vintagefilmography/homemade-telecine/README.md

# homemade-telecine
Homemade telecine unit to work with your existing DSLR.

This repo contains the instructions and parts list for the homemade telecine. The unit can be used with your existing camera 
with a macro lens.  
Read the enclosed manual for details.
