vintagefilmography/homemade-telecine/gate_design/film_gate1.jpg

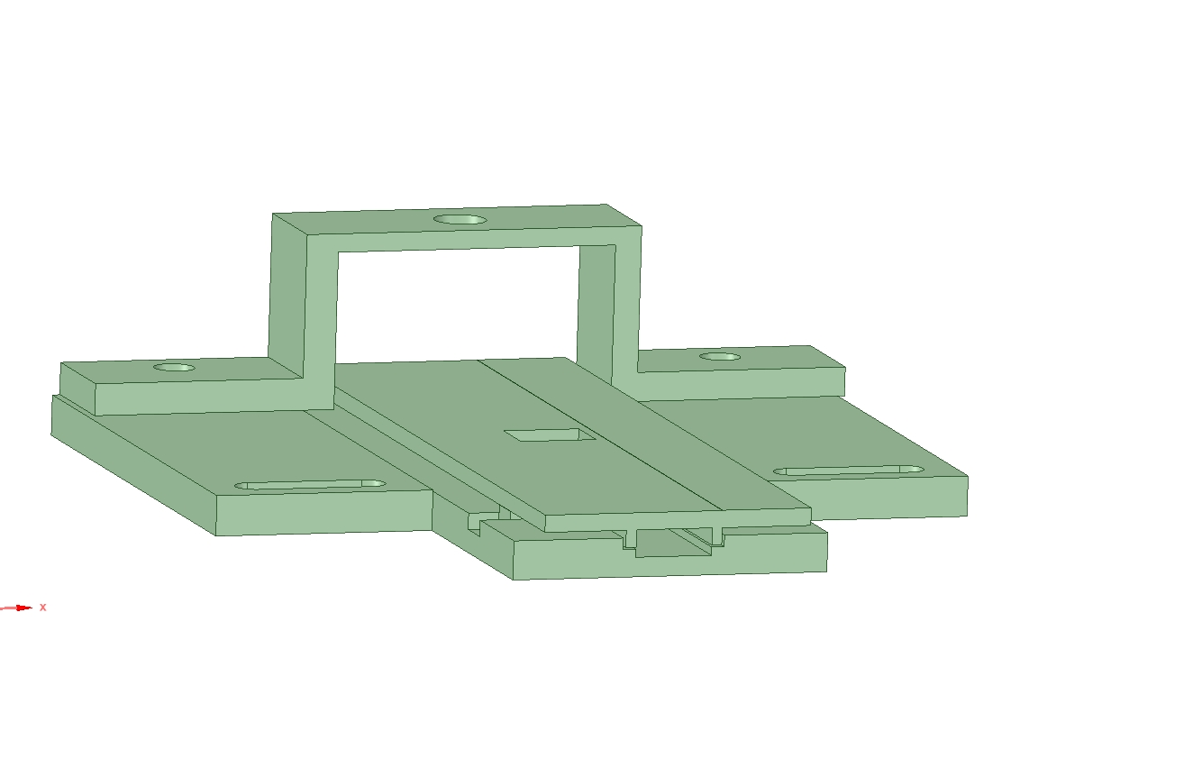
gate_design/film_gate1.jpg
