vintagefilmography/homemade-telecine/gate_design/film_gate2.jpg

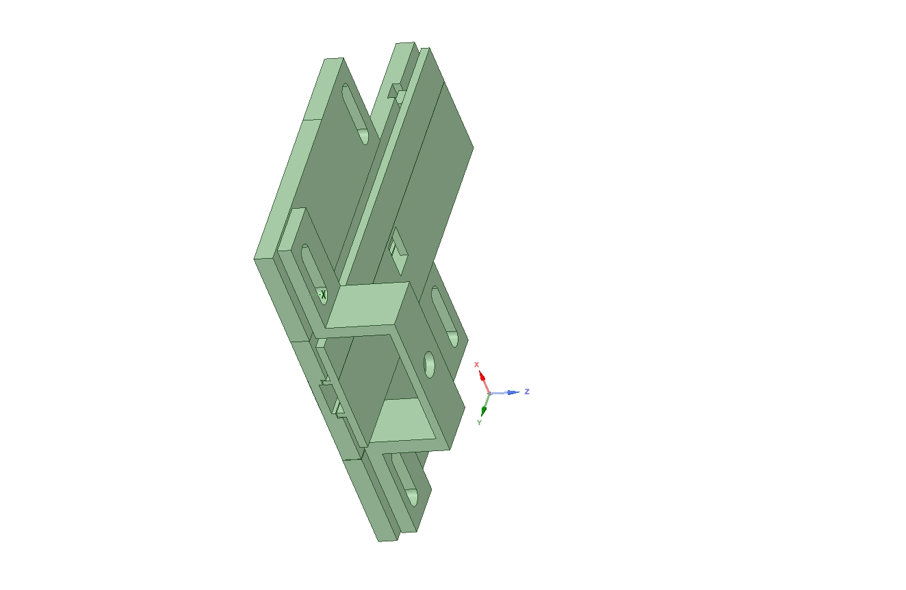
gate_design/film_gate2.jpg
