vintagefilmography/homemade-telecine/gate_design/film_gate.jpg

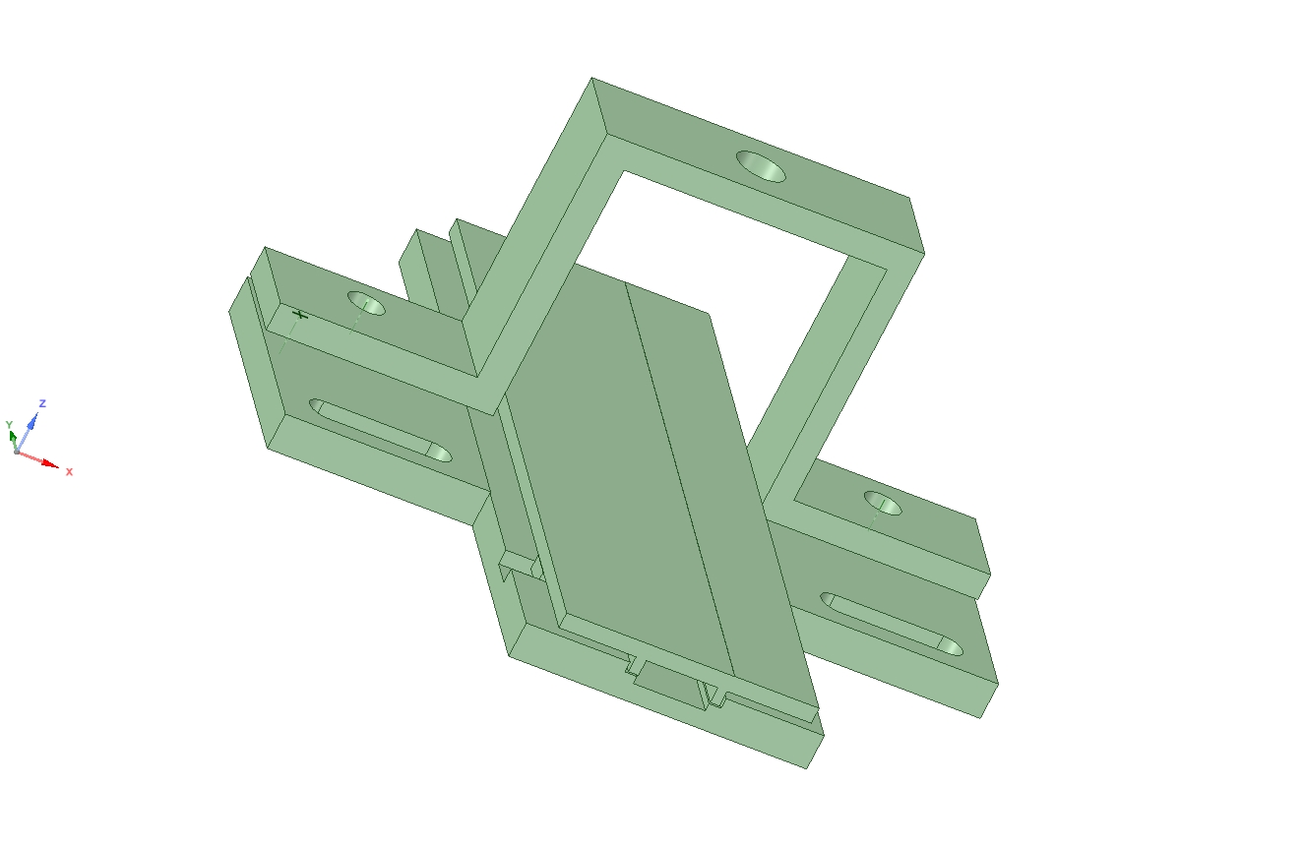
gate_design/film_gate.jpg
