vintagefilmography/homemade-telecine/gate_design/film_gate_concept3.jpg

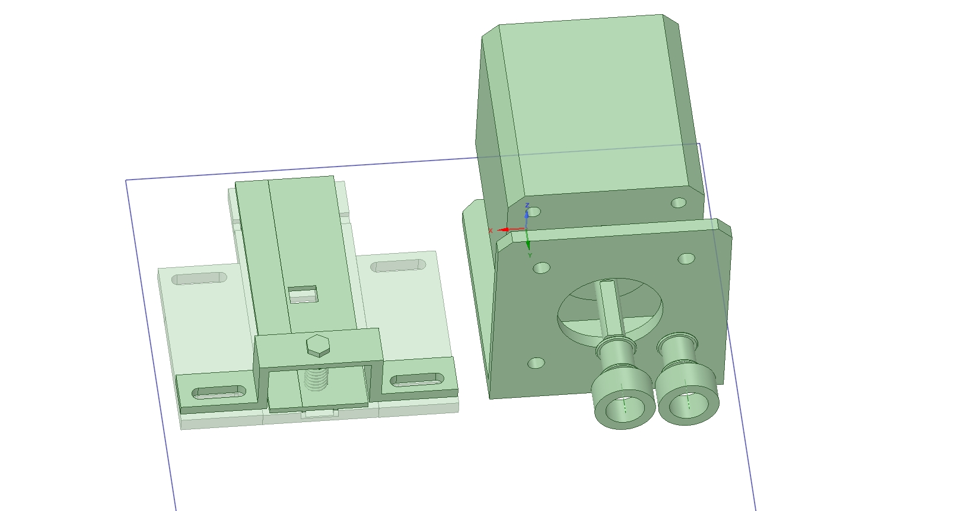
gate_design/film_gate_concept3.jpg
