vintagefilmography/homemade-telecine/gate_design/film_gate_concept.jpg

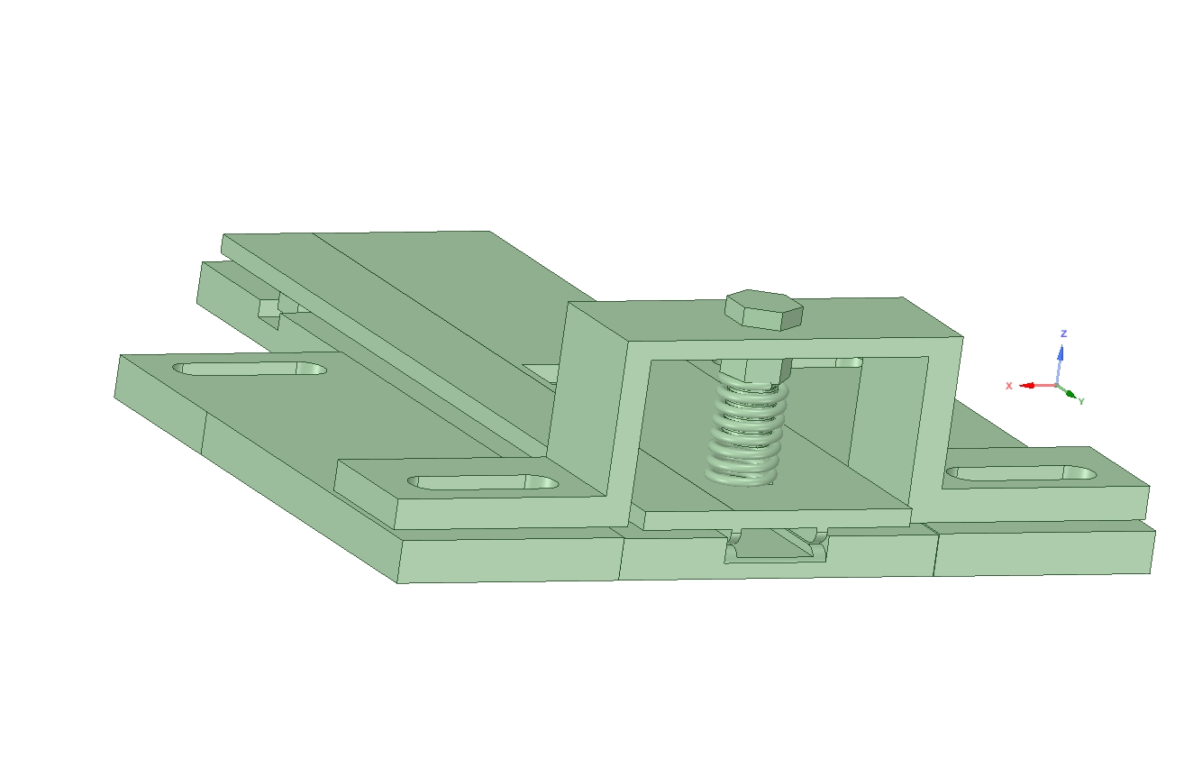
gate_design/film_gate_concept.jpg
