vintagefilmography/homemade-telecine/BOM-hawkeye2-V1.xlsx

Sheet: Sheet2
Ref | Qty | Part Num | Description | Value | Supplier | Cost | Ext Cost | Notes
C1 - not needed | 0 | 647-UMA1H010MDD1TP | Cap | 1uF | Mouser | 1.7 | 0
C2 - not needed | 0 | C322C104K5R5TA7303 | Cap | 0.1uF | Muser | 1.35 | 0
D1,D2,D3 | 1 |  | Diode |  | Amazon | 0.1 | 0.1 | https://www.amazon.com/gp/product/B01M9GOEFT/ref=ppx_od_dt_b_asin_title_s00?ie=UTF8&psc=1
IC1 | 1 | MSP430G2231IN14 | Controller |  | Mouser | 1.54 | 1.54 | 9
IC2 | 1 | NCP1117ST33T3G | Regulator |  | Digikey | 1.3 | 1.3
J3,J5,J8,J11 J1,J15 opt | 4 | WM1731-ND | Conn 2 pin |  | Digikey | 1.19 | 4.76
J4,J6,J26 | 3 | WM1733-ND | Conn 4 pin |  | Digikey | 0.28 | 0.84 | 5
 | 1 |  | Socket | DIP-14 for IC1 | Amazon | 1.2 | 1.2 | https://www.amazon.com/gp/product/B013SYPY9G/ref=ppx_od_dt_b_asin_title_s00?ie=UTF8&psc=1
Q1 - for capstan | 1 | IRF540NPBF | Mosfet |  | Amazon | 0.9 | 0.9 | https://www.amazon.com/gp/product/B07PH6FPZR/ref=ppx_od_dt_b_asin_title_s00?ie=UTF8&psc=1
R1,R4,R5,R6,R7 | 5 |  | Res | 10K | Amazon | 0.1 | 0.5 | https://www.amazon.com/gp/product/B07HDGX5LM/ref=ppx_yo_dt_b_asin_title_o06_s00?ie=UTF8&psc=1
R2 | 1 |  | Res | 3K | Amazon | 1.3 | 1.3 | https://www.amazon.com/gp/product/B07QG1VKCC/ref=ppx_yo_dt_b_asin_title_o00_s00?ie=UTF8&psc=1
R3 | 1 |  | Res | 100 | Amazon | 0.1 | 0.1 | https://www.amazon.com/gp/product/B0185FIDDW/ref=ppx_yo_dt_b_asin_title_o00_s00?ie=UTF8&psc=1
R5 | 1 |  | Res | 2.2K | Amazon | 0.1 | 0.1 | https://www.amazon.com/gp/product/B0185FIDDW/ref=ppx_yo_dt_b_asin_title_o00_s00?ie=UTF8&psc=1
R8 | 1 |  | Res | 1.7K | Amazon | 0.1 | 0.1 | https://www.amazon.com/gp/product/B07QG1V4YL/ref=ppx_yo_dt_b_asin_title_o06_s00?ie=UTF8&psc=1
R9 | 1 |  | Res | 1K | Amazon | 0.1 | 0.1 | https://www.amazon.com/gp/product/B07QG1V4YL/ref=ppx_yo_dt_b_asin_title_o06_s00?ie=UTF8&psc=1
 | 5 | WM15251-ND | Cable 2 pin |  | Digikey | 2.46 | 12.3
 | 2 | WM15259-ND | Cable 4 pin |  | Digikey | 3.54 | 7.08
 | 1 | PCB |  |  | JLCPCB | 2.8 | 2.8
 | 1 | Front panel PCB |  |  | JLCPCB | 2.5 | 2.5
 | 3 | Switches |  |  |  | 0.55 | 1.65
JP3 | 0 | Wolverine PS interface | Older non SMD alternative |  |  | 5 | 0 | http://www.mdfly.com/products/20p-20-pins-fpc-to-dip-breakout-board-0-5mm-pitch-pack-of-2.html
J17 | 1 | H125753CT-ND (https://www.digikey.com/product-detail/en/hirose-electric-co-ltd/FH28D-20S-0.5SH(05)/H125753CT-ND/8594832) | CONN FFC BOTTOM 20POS 0.50MM |  | Digikey | 1.63 | 1.63
 | 1 | Part procurement costs |  |  |  | 10 | 10
Total |  |  |  |  |  |  | 50.8
 | 1 | a17082900ux0309 | Motor |  | uxcell |  |  | http://www.uxcell.com/micro-motor-12v-4300rpm-%20wire-high-speed-encoder-motor-for-diy-hobby-toy-cars-remote-control-p-1323950.html
 | 1 | TLH 10-2s | Lens holder |  | theimagingsource
 | 4 |  | Spacers 3/8" |  | sparkfun.com |  |  | https://www.sparkfun.com/products/10461
 | 1 | DFM 72BUC02-ML | Camera |  | oemcameras.com
 | 1 | TBL 12-2 C 5MP | Lens |  | oemcameras.com
 | 1 | MSE14LDD7 | Sonalert |  | digikey | 30 | 30 | https://www.digikey.com/product-detail/en/mallory-sonalert-products-inc/MSE14LDD7/458-1319-ND/4895311&
 | 1 | Screws for cam mount |  |  | Amazon |  |  | https://www.amazon.com/gp/product/B01N1WDUK0/ref=ppx_yo_dt_b_asin_title_o00_s00?ie=UTF8&psc=1
 | 1 | extender cables for fan |  |  | Amazon |  |  | https://www.amazon.com/gp/product/B013JRWCBU/ref=ppx_yo_dt_b_asin_image_o07_s00?ie=UTF8&psc=1

Sheet: V6
Ref | Qty | Part Num | Description | Value | Supplier | Cost | Ext Cost | Notes
D1,D3,D4 | 3 |  | Diode |  | Amazon | 0.1 | 0.3 | https://www.amazon.com/gp/product/B01M9GOEFT/ref=ppx_od_dt_b_asin_title_s00?ie=UTF8&psc=1
IC1 | 1 | MSP430G2231IN14 | Controller |  | Digikey | 1.81 | 1.81 | 9
IC2 | 1 | NCP1117ST33T3G | Regulator |  | Digikey | 0.47 | 0.47
 | 1 |  | Socket | DIP-14 for IC1 | Amazon | 0.517 | 0.517 | https://www.amazon.com/gp/product/B013SYPY9G/ref=ppx_od_dt_b_asin_title_s00?ie=UTF8&psc=1
 | 11 |  | Resistor | 10K | Amazon | 0.8535 | 9.3885
 | 1 | PCBs |  |  | JLCPCB | 30.3 | 30.3
 | 6 | Switches |  |  |  |  | 14 | https://www.amazon.com/dp/B06ZZ24ZFL?psc=1
C1 | 1 | UMA1H010MDD1TP | 1µF 50V |  |  | 0.082 | 0.082
C2, C3, C4 | 3 | C322C104K5R5TA7303 | 0.1uF 50V |  | Mouser | 0.33 | 0.99
Q1,2 | 2 | 2N4401 |  |  | Digikey | 0.29 | 0.58 | https://www.digikey.com/product-detail/en/on-semiconductor/2N4401TAR/2N4401D75ZCT-ND/458924
Digikey shipping | 1 |  |  |  |  | 10 | 10
Assy and test | 1 |  |  |  |  | 30 | 30
S1 | 2 | B3F-1020 |  |  |  | 2.5 | 5 | https://www.amazon.com/dp/B00M1ZRSDE?psc=1
J46 | 1 | CP-050AH-ND (https://www.digikey.com/en/products/detail/cui-devices/PJ-050AH/1644583) | power jack |  | Digikey | 0.7 | 0.7
jJ7,14 | 2 | 8-Pin 2.54mm Pitch PCB Terminal Block |  |  |  | 10 | 20 | https://www.amazon.com/dp/B098QLRFMF?psc=1
Total PCB |  |  |  |  |  |  | 124.1375
Transport parts
 | 1 |  | Motor |  |  | 16 | 16 | https://www.amazon.com/gp/product/B00PNEQKC0
 | 1 |  | Pinch rollers |  |  | 35 | 35 | https://www.fruugo.us/recorder-parts-10x-video-pressure-belt-wheel-recorder-pulley-13x6x25mm-for-tape-deck/p-61842325-124662196
 | 1 |  | 3D parts |  |  | 200 | 200 | www.shapeways.com
 | 1 |  | misc hardware |  |  | 10 | 10
 | 1 |  | stepper controller |  |  | 35 | 35 | https://www.amazon.com/gp/product/B075HBJP51/
Transport Total |  |  |  |  |  |  | 296
LED | 1 |  |  |  |  |  | 11.79 | https://www.amazon.com/dp/B07DPQJZYZ?psc=1&ref=ppx_yo2_dt_b_product_details
Camera Mounting
 | 1 |  | camera slider |  | B&H | 100 | 100 | https://www.bhphotovideo.com/c/used/193311
 |  |  |  |  |  |  | 0
 |  |  |  |  |  |  | 0 | https://www.amazon.com/gp/product/B01N1WDUK0/ref=ppx_yo_dt_b_asin_title_o00_s00?ie=UTF8&psc=1
Camera mounting total |  |  |  |  |  |  | 100
Aluminum angle bar | 1 |  |  |  |  |  | 23.79 | https://www.amazon.com/gp/product/B000EUGY24/
Frame
 | 1 | Home Depot Shelf board |  |  |  | 10 | 10
Total |  |  |  |  |  |  | 565.7175

Sheet: Order
Ref | Qty | Part Num | Description | Value | Supplier | Cost | Ext Cost | Notes
J17 | 1 | H125753CT-ND (https://www.digikey.com/product-detail/en/hirose-electric-co-ltd/FH28D-20S-0.5SH(05)/H125753CT-ND/8594832) | CONN FFC BOTTOM 20POS 0.50MM |  | Digikey | 1.63 | 1.63
