vintagefilmography/homemade-telecine/gate_design/for-david/STL/gate_bottom_alternative.stl

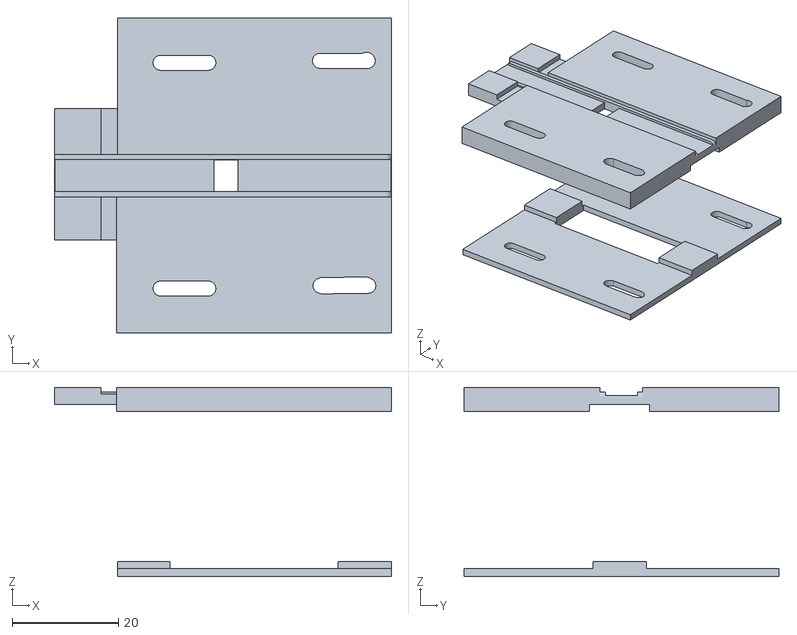
[picture p6: CAD file, 2021-11-20]
gate_design/for-david/STL/gate_bottom_alternative.stl
63.5 x 59.3 x 35.7
