vintagefilmography/homemade-telecine/sync-disk.stl

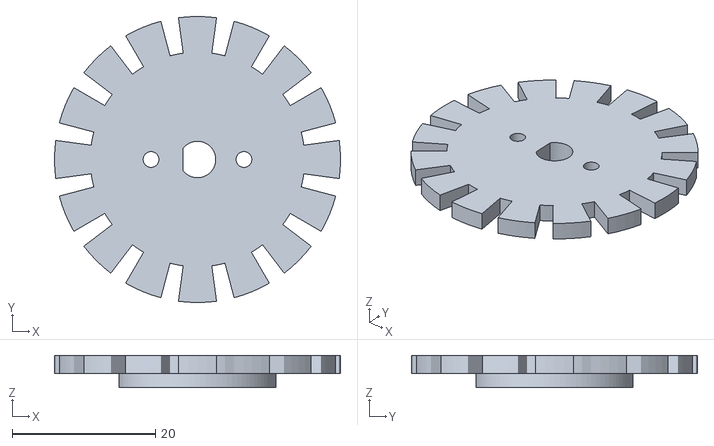
[picture p7: CAD file, 2021-05-23]
sync-disk.stl
40.0 x 40.0 x 4.50
