vintagefilmography/homemade-telecine/gate_design/for-david/STL/rocker.stl

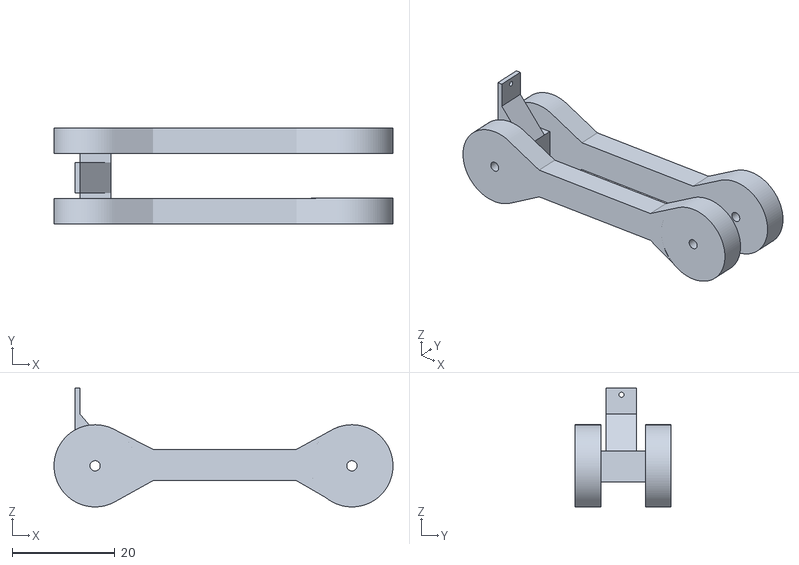
[picture p8: CAD file, 2021-11-17]
gate_design/for-david/STL/rocker.stl
66.0 x 18.8 x 23.1
