vintagefilmography/homemade-telecine/gate_design/for-david/STL/roller-bracket.stl

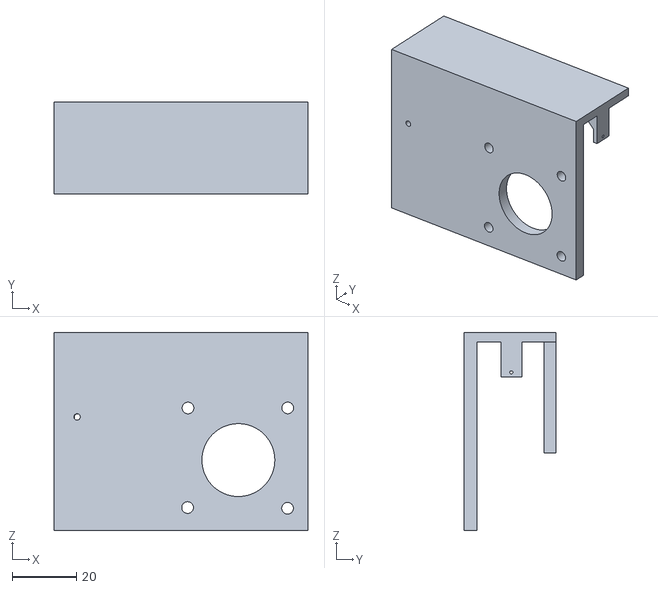
[picture p9: CAD file, 2021-11-17]
gate_design/for-david/STL/roller-bracket.stl
78.8 x 28.5 x 61.6
