vintagefilmography/homemade-telecine/gate_design/for-david/STL/roller_hub_stepper.stl

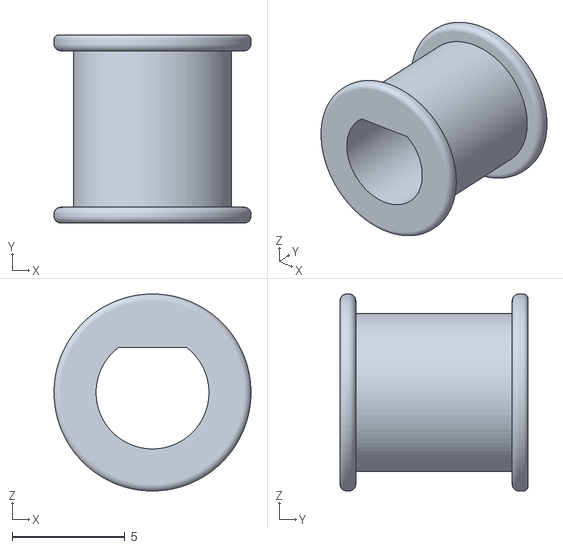
[picture p10: CAD file, 2021-11-15]
gate_design/for-david/STL/roller_hub_stepper.stl
8.73 x 8.33 x 8.73
