vintagefilmography/homemade-telecine/gate_design/for-david/STL/gate_top_tensioner.stl

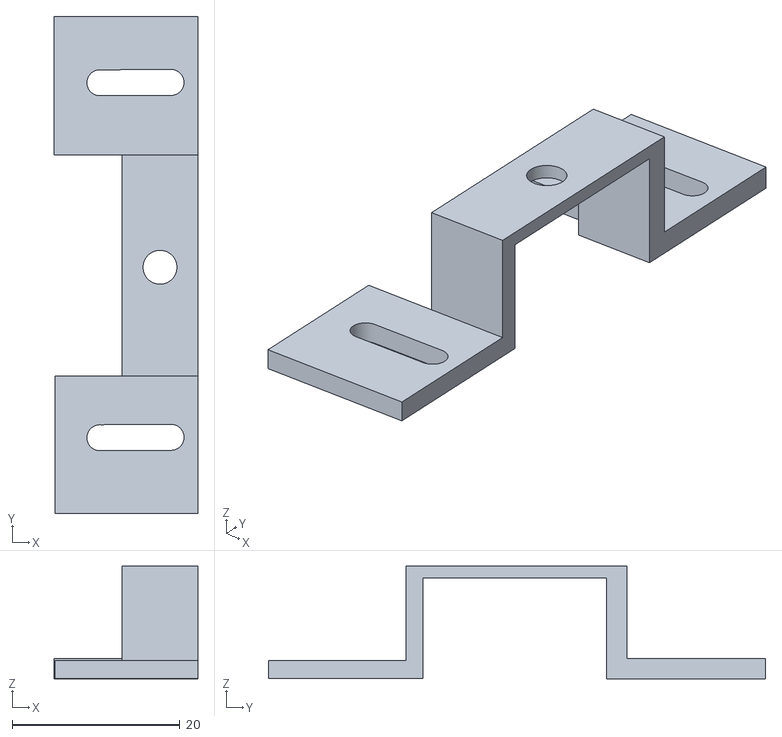
[picture p11: CAD file, 2021-11-15]
gate_design/for-david/STL/gate_top_tensioner.stl
17.1 x 59.3 x 13.5
