vintagefilmography/homemade-telecine/gate_design/for-david/STL/led_housing.stl

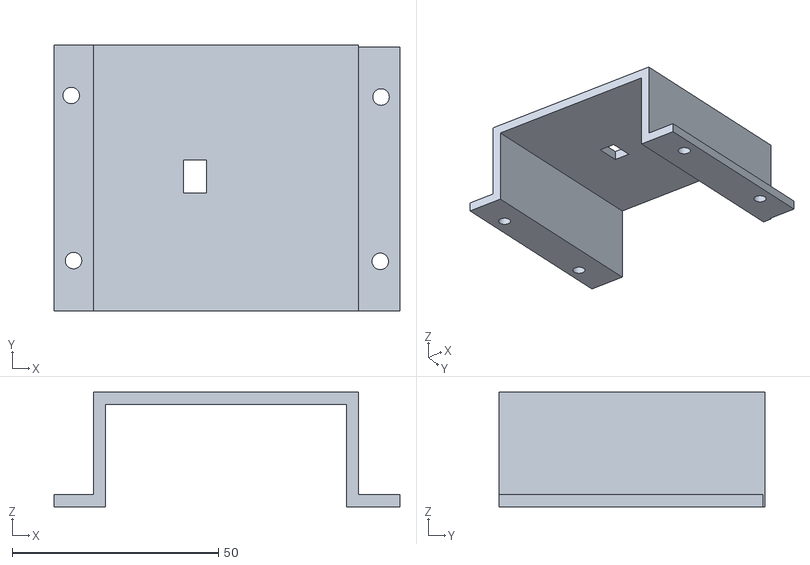
[picture p12: CAD file, 2021-11-15]
gate_design/for-david/STL/led_housing.stl
83.9 x 64.5 x 27.9
