vintagefilmography/homemade-telecine/gate_design/for-david/STL/gate_top.stl

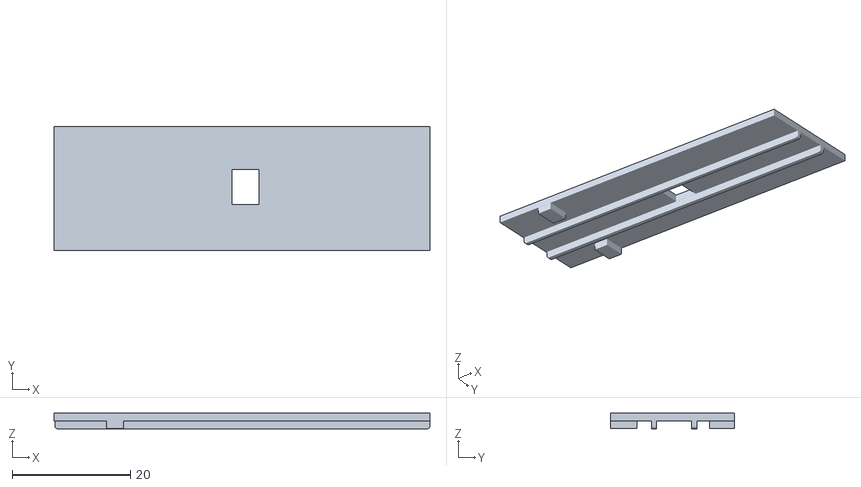
[picture p13: CAD file, 2021-11-15]
gate_design/for-david/STL/gate_top.stl
63.6 x 21.0 x 2.67
