vintagefilmography/homemade-telecine/gate_design/for-david/STL/stepper_bracket.stl

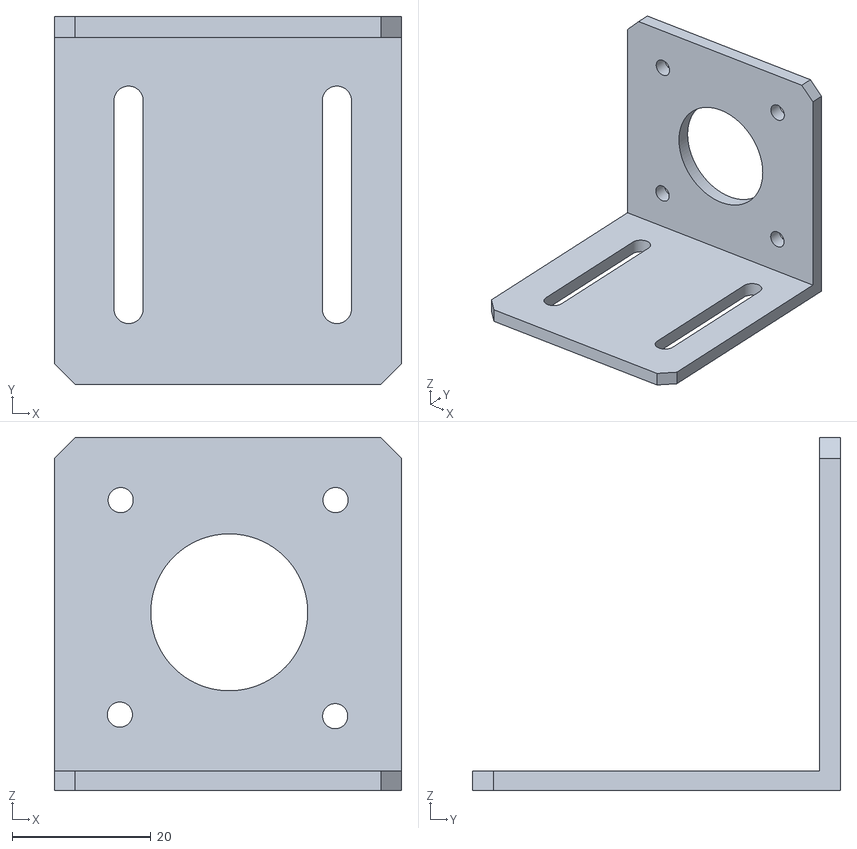
[picture p14: CAD file, 2021-11-15]
gate_design/for-david/STL/stepper_bracket.stl
50.0 x 53.0 x 50.8
