vintagefilmography/homemade-telecine/gate_design/for-david/STL/shaft.stl

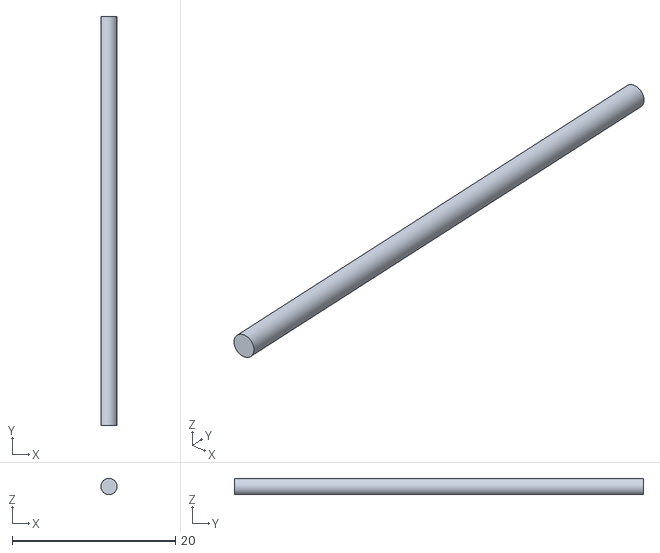
[picture p15: CAD file, 2021-11-15]
gate_design/for-david/STL/shaft.stl
2.00 x 50.2 x 2.00
