vintagefilmography/homemade-telecine/gate_design/for-david/STL/gate_bottom.stl

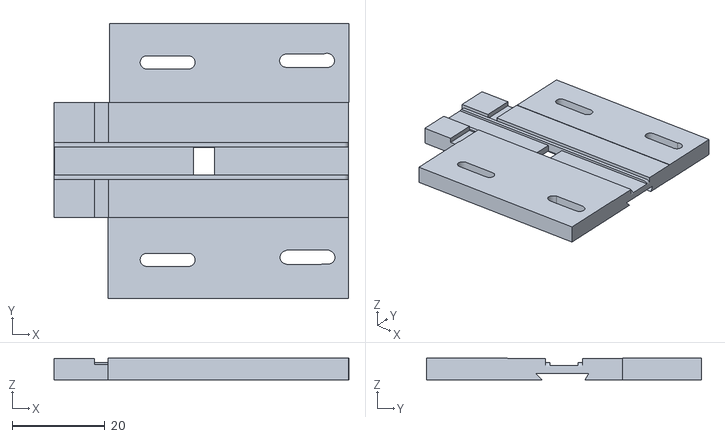
[picture p16: CAD file, 2021-11-15]
gate_design/for-david/STL/gate_bottom.stl
63.6 x 59.3 x 4.66
