vintagefilmography/homemade-telecine/gate_design/for-david/STL/roller_idler.stl

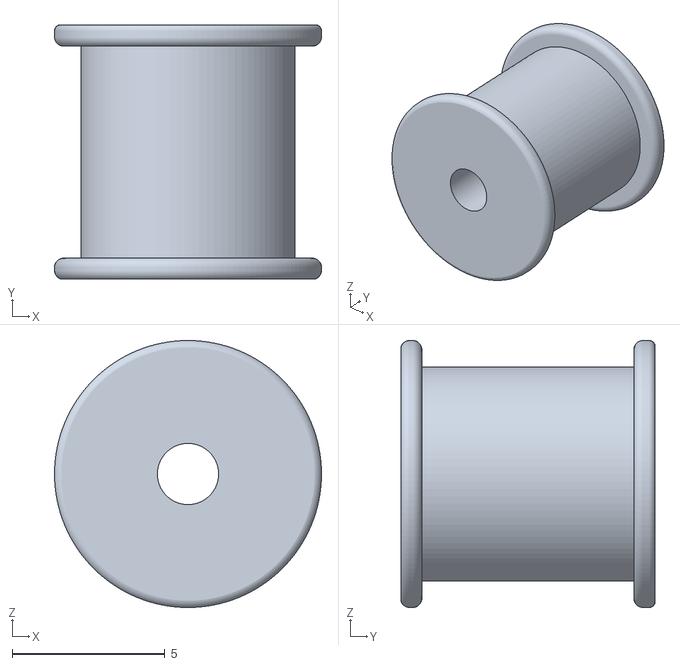
[picture p17: CAD file, 2021-11-15]
gate_design/for-david/STL/roller_idler.stl
8.73 x 8.32 x 8.73
