vintagefilmography/homemade-telecine/gate_design/film_gate_assembly1.jpg

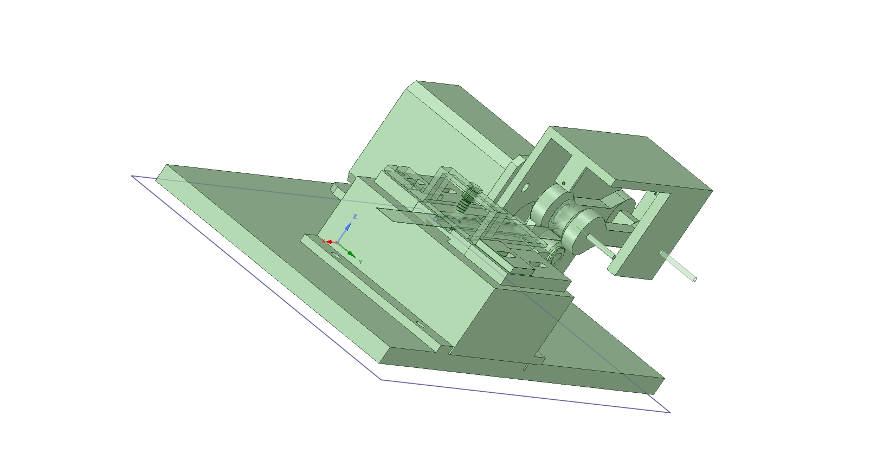
gate_design/film_gate_assembly1.jpg
