vintagefilmography/homemade-telecine/gate_design/film_gate_assembly.jpg

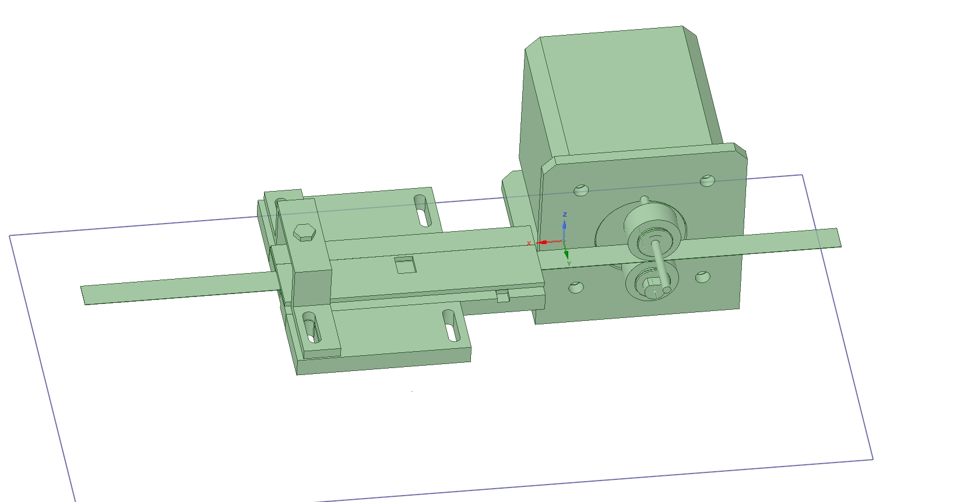
gate_design/film_gate_assembly.jpg
