vintagefilmography/homemade-telecine/gate_design/for-david/STL/assembly1-instructions.jpg

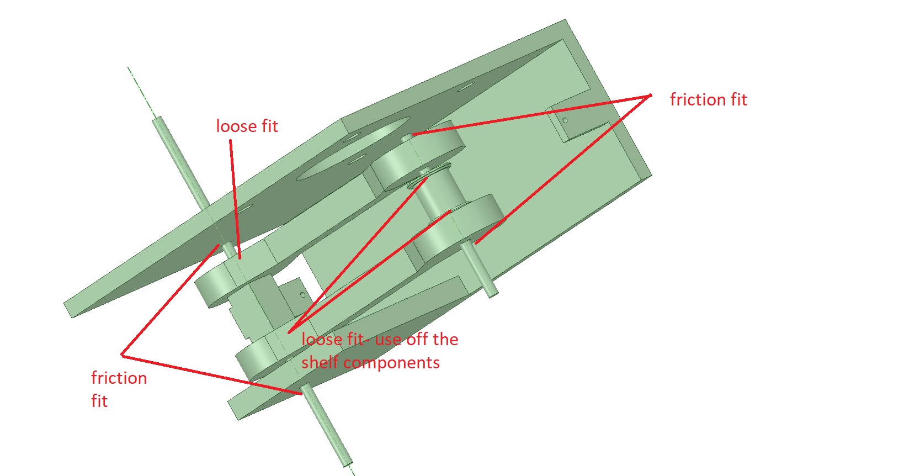
gate_design/for-david/STL/assembly1-instructions.jpg
