vintagefilmography/homemade-telecine/gate_design/for-david/STL/assembly1.jpg

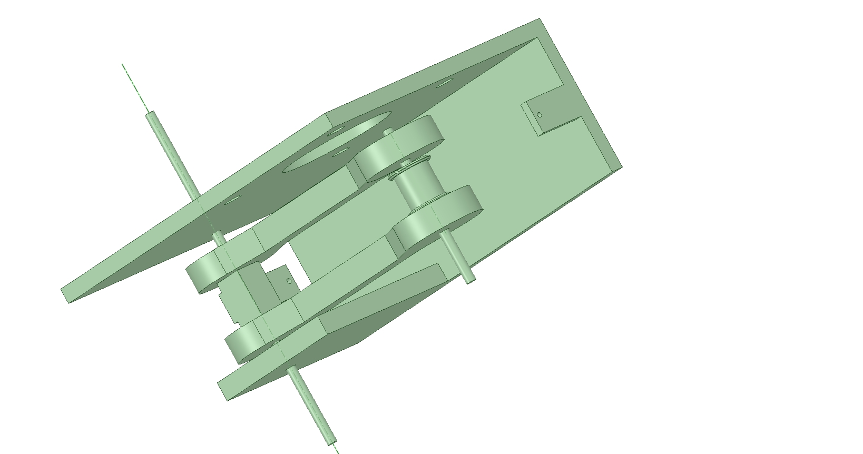
gate_design/for-david/STL/assembly1.jpg
